70p4z/samsung-f3-f4-usb-adapter/pcb/image_r2.png

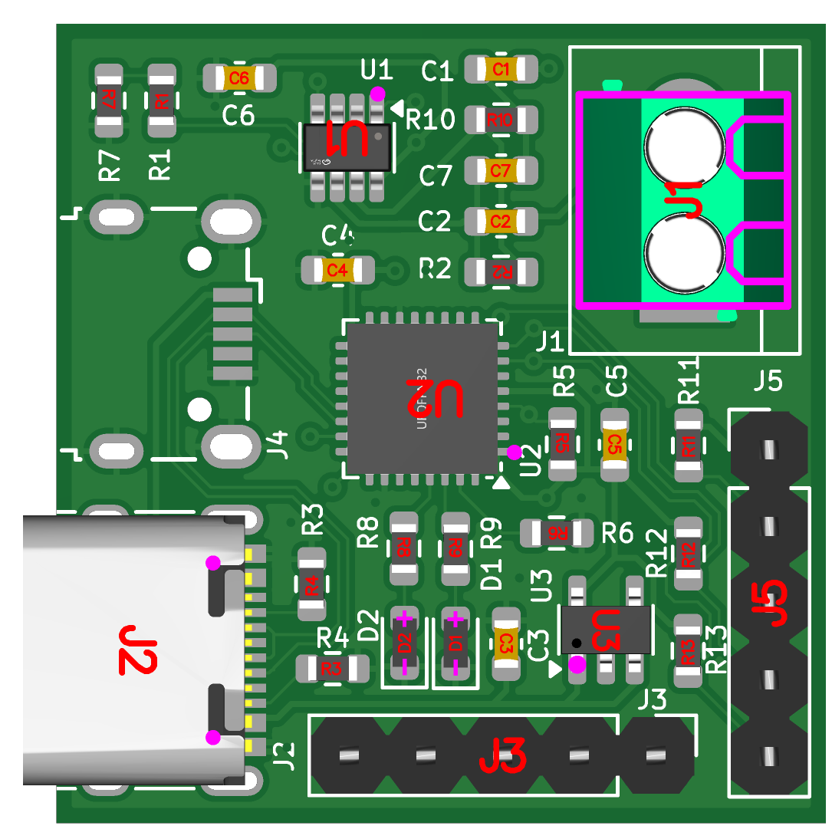
pcb/image_r2.png
