70p4z/samsung-f3-f4-usb-adapter/pcb/f3f4_bridge.kicad_pcb

## KiCad design pcb/f3f4_bridge.kicad_pcb (2025-06-20)

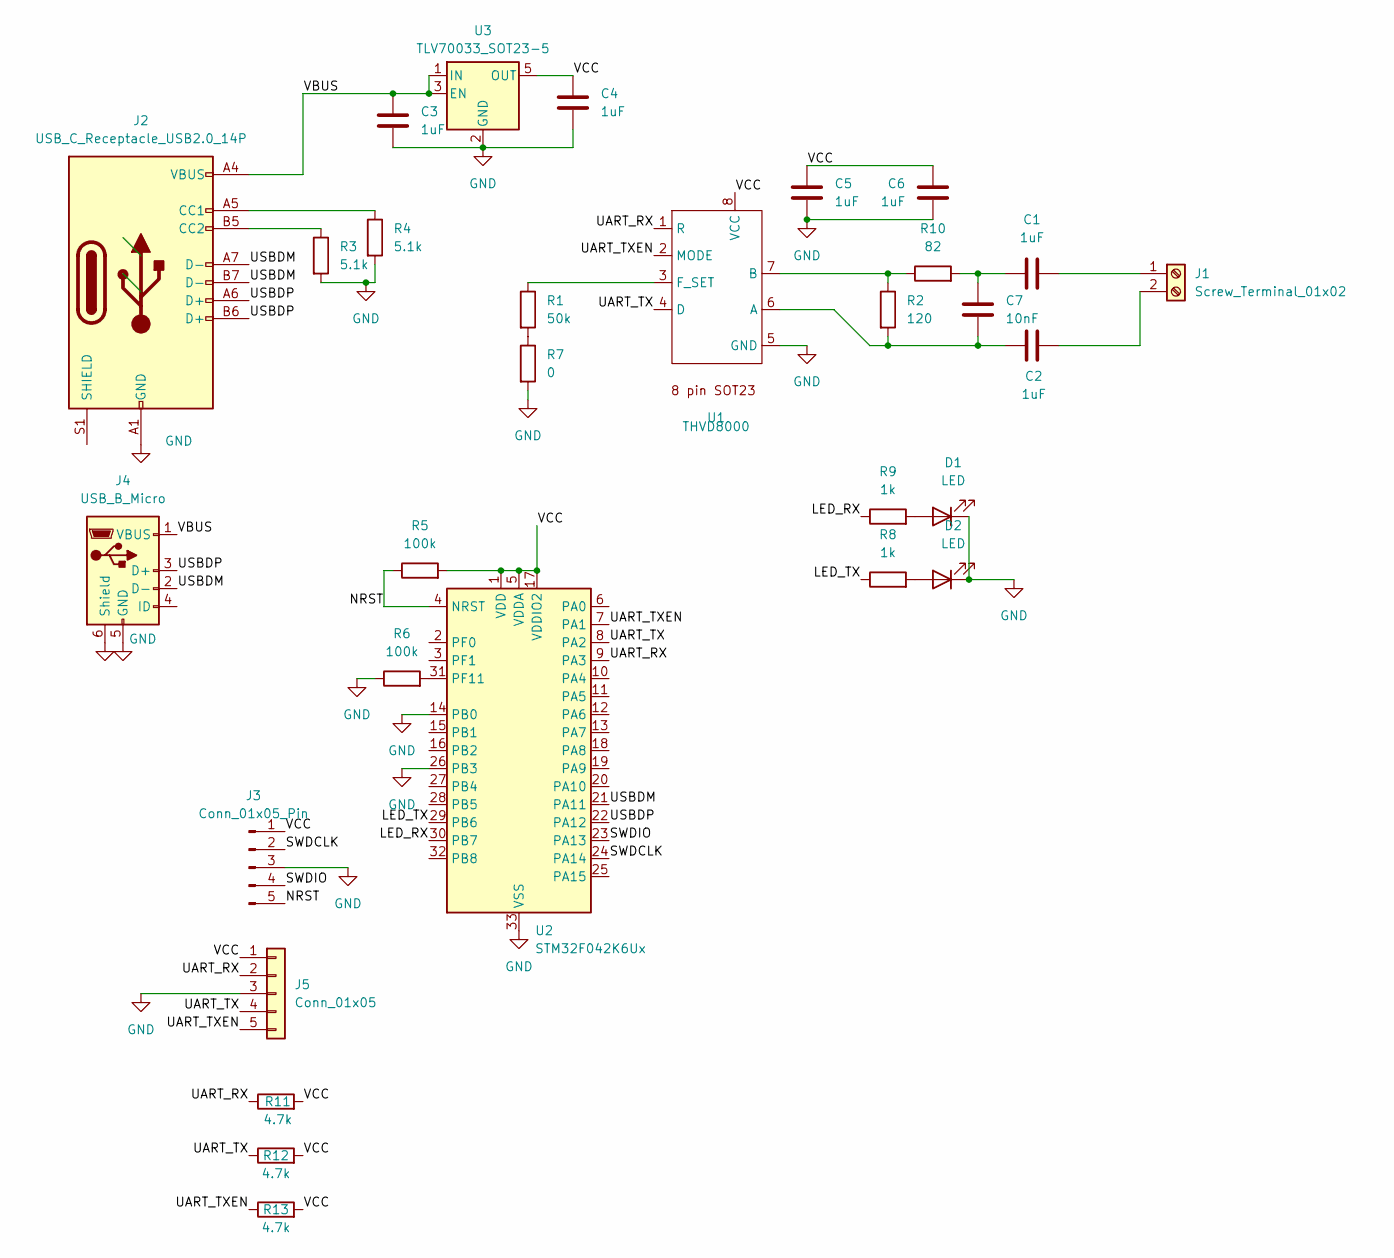
[picture p2: schematic f3f4_bridge.kicad_sch]

Parts:
C1, C2, C3, C4, C5, C6: 1uF; C_0603_1608Metric; LCSC C15849
C7: 10nF; C_0603_1608Metric; LCSC C57112
D1, D2: LED; LED_0603_1608Metric; LCSC C2286
J1: Screw_Terminal_01x02; TerminalBlock_bornier-2_P5.08mm; LCSC C709041
J2: USB_C_Receptacle_USB2.0_14P; USB_C_Receptacle_XKB_U262-16XN-4BVC11; LCSC C2765186
J3: Conn_01x05_Pin; PinHeader_1x05_P2.54mm_Vertical; LCSC C492404
J4: USB_B_Micro; USB_Micro-B_Wuerth_629105150521
J5: Conn_01x05; PinHeader_1x05_P2.54mm_Vertical; LCSC C492404
R1: 50k; R_0603_1608Metric; LCSC C25819
R2: 120; R_0603_1608Metric; LCSC C22787
R3, R4: 5.1k; R_0603_1608Metric; LCSC C23186
R5, R6: 100k; R_0603_1608Metric; LCSC C25803
R7: 0; R_0603_1608Metric; LCSC C4211
R8, R9: 1k; R_0603_1608Metric; LCSC C21190
R10: 82; R_0603_1608Metric; LCSC C23255
R11, R12, R13: 4.7k; R_0603_1608Metric; LCSC C23162
U1: THVD8000; SOT-23-8; LCSC C2848812
U2: STM32F042K6Ux; QFN-32-1EP_5x5mm_P0.5mm_EP3.45x3.45mm; LCSC C2053439
U3: TLV70033_SOT23-5; SOT-23-5; LCSC C5884123

Connections:
/LED_RX: R9.1, U2.30 (PB7)
/LED_TX: R8.1, U2.29 (PB6)
/NRST: J3.5, R5.1, U2.4 (NRST)
/SWDCLK: J3.2, U2.24 (PA14)
/SWDIO: J3.4, U2.23 (PA13)
/UART_RX: J5.2, R11.1, U1.1 (R), U2.9 (PA3)
/UART_TX: J5.4, R12.1, U1.4 (D), U2.8 (PA2)
/UART_TXEN: J5.5, R13.1, U1.2 (MODE), U2.7 (PA1)
/USBDM: J2.A7 (D-), J2.B7 (D-), J4.2 (D-), U2.21 (PA11)
/USBDP: J2.A6 (D+), J2.B6 (D+), J4.3 (D+), U2.22 (PA12)
/VBUS: C3.2, J2.A4 (VBUS), J2.A9 (VBUS), J2.B4 (VBUS), J2.B9 (VBUS), J4.1 (VBUS), U3.1 (IN), U3.3 (EN)
/VCC: C4.2, C5.2, C6.2, J3.1, J5.1, R5.2, R11.2, R12.2, R13.2, U1.8 (VCC), U2.1 (VDD), U2.5 (VDDA), U2.17 (VDDIO2), U3.5 (OUT)
GND: C3.1, C4.1, C5.1, C6.1, D1.1 (K), D2.1 (K), J2.A1 (GND), J2.A12 (GND), J2.B1 (GND), J2.B12 (GND), J3.3, J4.5 (GND), J4.6 (Shield), J5.3, R3.2, R4.2, R6.1, R7.2, U1.5 (GND), U2.14 (PB0), U2.26 (PB3), U2.33 (VSS), U3.2 (GND)
unnamed: C1.1, C7.2, R10.2
unnamed: D1.2 (A), R9.2
unnamed: D2.2 (A), R8.2
unnamed: C1.2, J1.1
unnamed: C2.2, J1.2
unnamed: J2.A5 (CC1), R4.1
unnamed: J2.B5 (CC2), R3.1
unnamed: R1.2, R7.1
unnamed: C2.1, C7.1, R2.2, U1.6 (A)
unnamed: R2.1, R10.1, U1.7 (B)
unnamed: R1.1, U1.3 (F_SET)
unnamed: R6.2, U2.31 (PF11)

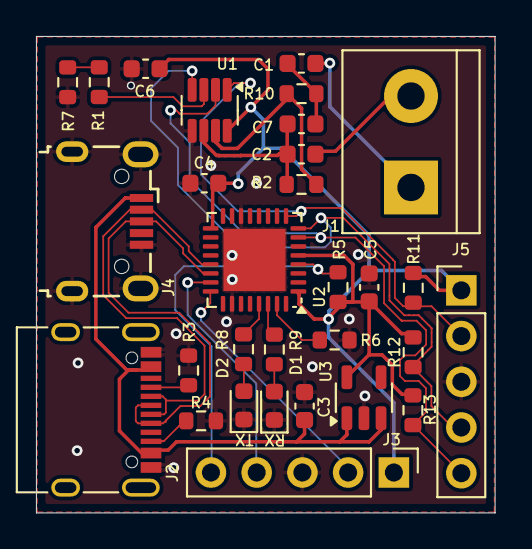
[picture p3: board f3f4_bridge.kicad_pcb from above]

Board: 2 copper layers, 25.5 x 26.5 mm, 30 parts (0 on the bottom side), 25 nets.
