70p4z/samsung-f3-f4-usb-adapter/Core/Src/main.c

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
/* Includes ------------------------------------------------------------------*/
#include "main.h"
#include "usb_device.h"

#define HOST_USB
#define USART_INTF USART2
#define TXEN_Pin GPIO_PIN_1
#define TXEN_Port GPIOA

#define LEDTX_Pin GPIO_PIN_6
#define LEDTX_Port GPIOB

#define LEDRX_Pin GPIO_PIN_7
#define LEDRX_Port GPIOB

#define LED_TIMEOUT 100

UART_HandleTypeDef huart;

void SystemClock_Config(void);
static void MX_GPIO_Init(void);
static void MX_USART_UART_Init(void);
/* USER CODE BEGIN PFP */

#define USB_RX_LATENCY_MS 20

uint32_t upgrade_mode;
uint32_t usb_configured;
uint8_t usb_rx[CDC_DATA_FS_MAX_PACKET_SIZE];
uint32_t usb_rx_len;
uint32_t usb_rx_fwd_off;
uint8_t usb_tx[CDC_DATA_FS_MAX_PACKET_SIZE];
uint8_t usb_tx_bg[CDC_DATA_FS_MAX_PACKET_SIZE];
uint32_t usb_tx_off;
uint32_t usb_tx_lastadd;

/* USER CODE END PFP */

/* USER CODE BEGIN 0 */

int8_t CDC_Receive_FS(uint8_t* Buf, uint32_t *Len)
{
  if (usb_rx == Buf) {
    usb_rx_len = *Len;
    usb_rx_fwd_off=0;
  }
  return (0);
}

void main_cdc_init(void) {
  usb_configured = 1;
  USBD_CDC_SetRxBuffer(&hUsbDeviceFS, usb_rx);
  USBD_CDC_ReceivePacket(&hUsbDeviceFS);
}

/* USER CODE END 0 */

/**
  * @brief  The application entry point.
  * @retval int
  */
int main(void)
{
  /* MCU Configuration--------------------------------------------------------*/

  /* Reset of all peripherals, Initializes the Flash interface and the Systick. */
  HAL_Init();

  /* Configure the system clock */
  SystemClock_Config();

  /* Initialize all configured peripherals */
  MX_GPIO_Init();
  MX_USART_UART_Init();
  usb_configured = 0;
  MX_USB_DEVICE_Init();
  /* USER CODE BEGIN 2 */

  // nothing to transmit so far
  usb_tx_off=0;
  usb_tx_lastadd=0;
  // nothing received so far
  usb_rx_len=usb_rx_fwd_off=0;

  HAL_GPIO_WritePin(LEDTX_Port, LEDTX_Pin, GPIO_PIN_SET);
  HAL_GPIO_WritePin(LEDRX_Port, LEDRX_Pin, GPIO_PIN_SET);

  uint32_t ledtx_timeout = uwTick + LED_TIMEOUT;
  uint32_t ledrx_timeout = uwTick + LED_TIMEOUT;
  /* USER CODE END 2 */

  /* Infinite loop */
  /* USER CODE BEGIN WHILE */
  while (1)
  {
    /* USER CODE END WHILE */

    if (LL_USART_IsActiveFlag_RXNE(USART_INTF)) {
      // read and append character to the usb buffer
      uint8_t b = LL_USART_ReceiveData8(USART_INTF);
      // and send it
      usb_tx[usb_tx_off++] = b;

      HAL_GPIO_WritePin(LEDRX_Port, LEDRX_Pin, GPIO_PIN_SET);
      ledrx_timeout = uwTick + LED_TIMEOUT;
      if (!ledrx_timeout) ledrx_timeout++;
      
      if (usb_tx_off==sizeof(usb_tx)
        && usb_configured) {
        // immediate sending
        memmove(usb_tx_bg, usb_tx, usb_tx_off);
        USBD_CDC_SetTxBuffer(&hUsbDeviceFS, usb_tx_bg, usb_tx_off);
        USBD_CDC_TransmitPacket(&hUsbDeviceFS);
        usb_tx_off=0;
        usb_tx_lastadd=0;
      }
      else {
        // send after timeout (not to make the usb too busy)
        usb_tx_lastadd=uwTick+USB_RX_LATENCY_MS;
        if (usb_tx_lastadd == 0) usb_tx_lastadd++;
      }
    }

    // expired time to fwd the received data?
    if (usb_tx_off && usb_tx_lastadd && uwTick - usb_tx_lastadd < 0x80000000U
      && usb_configured) {
      usb_tx_lastadd = 0;
      memmove(usb_tx_bg, usb_tx, usb_tx_off);
      USBD_CDC_SetTxBuffer(&hUsbDeviceFS, usb_tx_bg, usb_tx_off);
      USBD_CDC_TransmitPacket(&hUsbDeviceFS);
      usb_tx_off=0;
    }

    // transmit data from usb_rx toward usart
    if (LL_USART_IsActiveFlag_TXE(USART_INTF)) {
      if (usb_rx_len 
        && usb_rx_fwd_off < usb_rx_len) {
        
        HAL_GPIO_WritePin(LEDTX_Port, LEDTX_Pin, GPIO_PIN_SET);
        ledtx_timeout = uwTick + LED_TIMEOUT;
        if (!ledtx_timeout) ledtx_timeout++;

        if (upgrade_mode) {
          WRITE_REG(FLASH->KEYR, FLASH_KEY1);
          WRITE_REG(FLASH->KEYR, FLASH_KEY2);
          /* Only bank1 will be erased*/
          SET_BIT(FLASH->CR, FLASH_CR_MER);
          SET_BIT(FLASH->CR, FLASH_CR_STRT);
          FLASH_WaitForLastOperation((uint32_t)FLASH_TIMEOUT_VALUE);
          NVIC_SystemReset();
        }

        uint32_t timeout = uwTick + 1000;
        // transmission will occur on RS485
        HAL_GPIO_WritePin(TXEN_Port, TXEN_Pin, GPIO_PIN_SET);
        // send byte
        LL_USART_TransmitData8(USART_INTF, usb_rx[usb_rx_fwd_off++]);
        // wait transmission ended
        while (!LL_USART_IsActiveFlag_TC(USART_INTF)) { 
          if (uwTick - timeout < 0x80000000U) {
            break;
          }
        }
        // transmission ended, back to RX on RS485
        HAL_GPIO_WritePin(TXEN_Port, TXEN_Pin, GPIO_PIN_RESET);
        // prepare reception of next usb chunk
        if (usb_rx_fwd_off==usb_rx_len) {
          USBD_CDC_ReceivePacket(&hUsbDeviceFS);
        }
      }
    }

    if (ledrx_timeout &&  uwTick - ledrx_timeout < 0x80000000UL) {
      ledrx_timeout = 0;
      HAL_GPIO_WritePin(LEDRX_Port, LEDRX_Pin, GPIO_PIN_RESET);
    }

    if (ledtx_timeout &&  uwTick - ledtx_timeout < 0x80000000UL) {
      ledtx_timeout = 0;
      HAL_GPIO_WritePin(LEDTX_Port, LEDTX_Pin, GPIO_PIN_RESET);
    }

    if (LL_USART_IsActiveFlag_ORE(USART_INTF)) {
      LL_USART_ClearFlag_ORE(USART_INTF);
    }
    if (LL_USART_IsActiveFlag_NE(USART_INTF)) {
      LL_USART_ClearFlag_NE(USART_INTF);
    }
    if (LL_USART_IsActiveFlag_FE(USART_INTF)) {
      LL_USART_ClearFlag_FE(USART_INTF);
    }
    if (LL_USART_IsActiveFlag_PE(USART_INTF)) {
      LL_USART_ClearFlag_PE(USART_INTF);
    }

    /* USER CODE BEGIN 3 */
  }
  /* USER CODE END 3 */
}

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
