70p4z/samsung-f3-f4-usb-adapter/f3f4-usb-adapter.ioc

Mcu.UserName=STM32F042K6Tx
PA1.GPIO_Label=TXEN
PA1.Signal=GPIO_Output
PA11.Signal=USB_DM
PA12.Signal=USB_DP
PA13.Signal=SYS_SWDIO
PA14.Signal=SYS_SWCLK
PA2.Signal=USART2_TX
PA3.Signal=USART2_RX
