70p4z/samsung-f3-f4-usb-adapter/(commit log)

2025-02-12 add PCB design
    [f3f4_bridge.kicad_pcb, f3f4_bridge.kicad_sch]
2025-06-02 avoid hangs upon uart errors
    [main.c]
2025-06-02 add led tx and led rx driver
2025-06-19 add back to STM32 bootloader (masserase) add rule to flash using dfu-util fix led lighting
    [f3f4_bridge.kicad_pcb, f3f4_bridge.kicad_sch]
2025-06-19 - make the state machine more robust vs usb enumeration - fix pin modes for usart and txen - fix pin pull resistor to allow external dupont header for thvd interaction
    [main.c]
2025-06-20 fix invalid inverted rx and tx leds
    [f3f4_bridge.kicad_pcb, f3f4_bridge.kicad_sch]
2025-07-07 add nvic reset upon errors commit gerbers and a board image
    [main.c]
